TexablePlum/PixelTree/LaTeX/source/Hardwere/tabela parametrów diody WS2812D.jpg

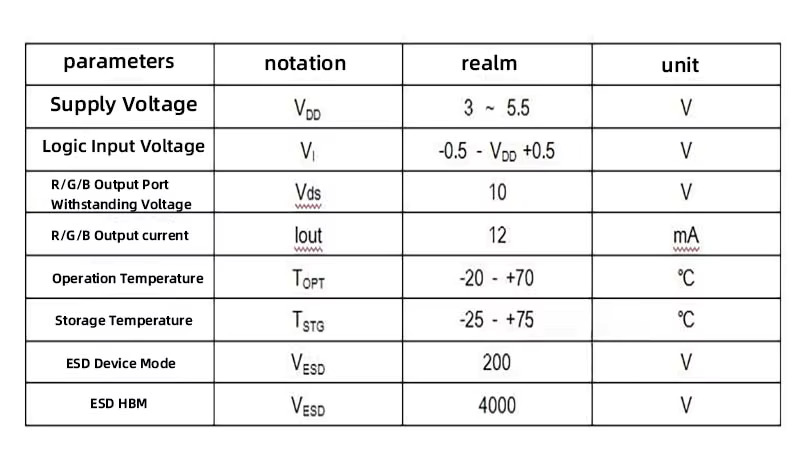
LaTeX/source/Hardwere/tabela parametrów diody WS2812D.jpg
