TexablePlum/PixelTree/Case/pixeltree_base.stl

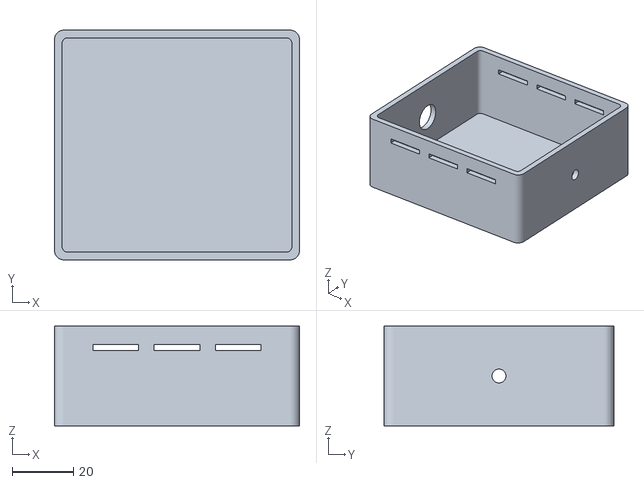
[picture p29: CAD file, 2025-12-28]
Case/pixeltree_base.stl
80.0 x 75.0 x 32.5
