TexablePlum/PixelTree/Case/pixeltree_lid.stl

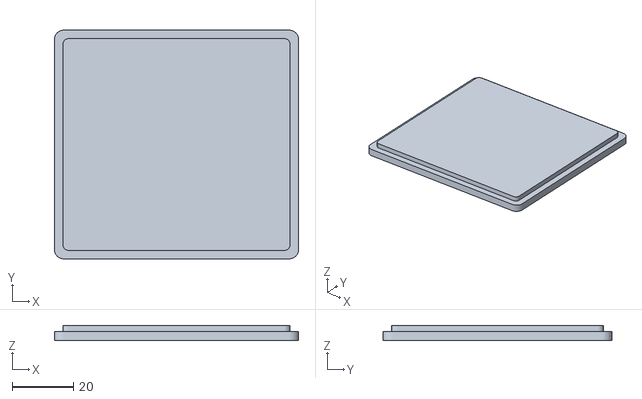
[picture p30: CAD file, 2025-12-28]
Case/pixeltree_lid.stl
80.0 x 75.0 x 5.00
